AbiesDSP/headphone_dac_proto/README.md

# headphone_dac_proto
Prototype USB DAC to test Cypress PSoC 5lp USB "bridge", I2S DAC, and analog output amplifier
