AbiesDSP/headphone_dac_proto/headphone_dac_proto.kicad_pcb

## KiCad design headphone_dac_proto.kicad_pcb (2020-11-06)

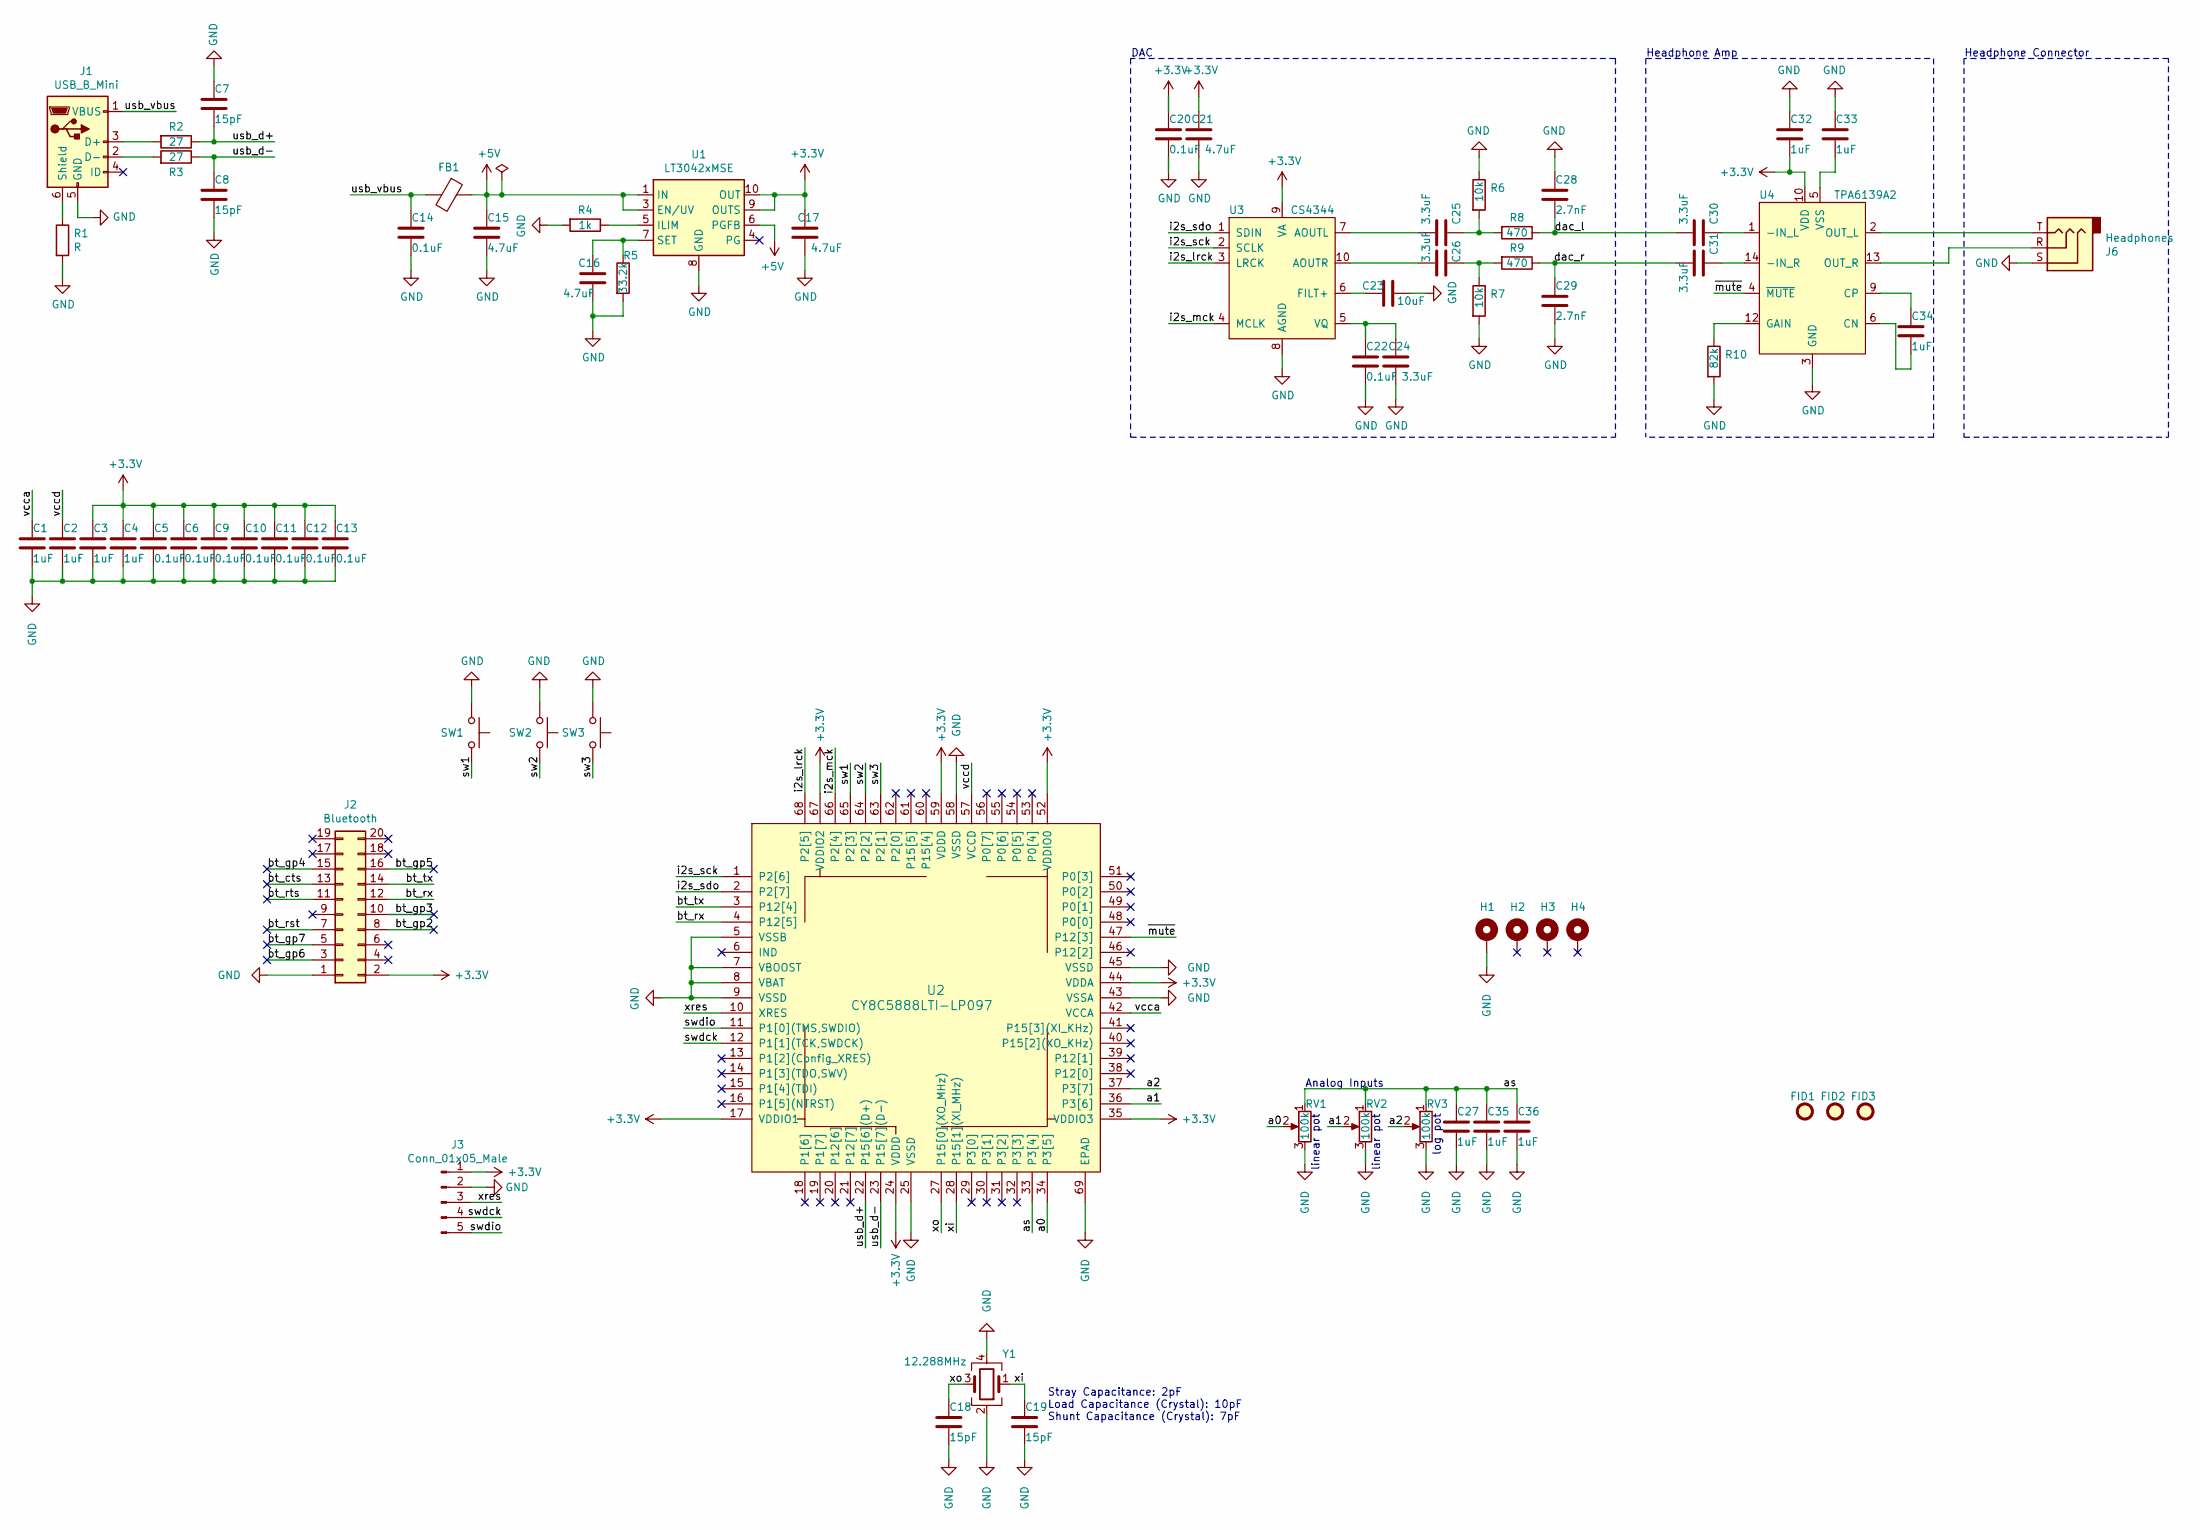
[picture p1: schematic headphone_dac_proto.sch]

Parts:
C1, C2, C3, C4, C27, C32, C33, C34, C35, C36: 1uF; C_0603_1608Metric; Manufacturer Part Number C0603C105K3RAC7411; Mouser Part Number 80-C0603C105K3RLR
C5, C6, C9, C10, C11, C12, C13, C14, C20, C22: 0.1uF; C_0603_1608Metric; Manufacturer Part Number C0603C104K5RAC3121; Mouser Part Number 80-C603C104K5RAC3121
C7, C8, C18, C19: 15pF; C_0603_1608Metric; Manufacturer Part Number C0603C150K5RAC7867; Mouser Part Number 80-C0603C150K5RACTU
C15, C16, C17, C21: 4.7uF; C_0805_2012Metric; Manufacturer Part Number C0805C475K3RACTU; Mouser Part Number 80-C0805C475K3RACTU
C23: 10uF; C_0805_2012Metric; Manufacturer Part Number C0805C106K8RACAUTO; Mouser Part Number 80-C0805C106K8RAUTO
C24, C25, C26, C30, C31: 3.3uF; C_0805_2012Metric; Manufacturer Part Number CGA4J1X7R1E335K125AC; Mouser Part Number 810-CGA4J1X7R1E335K
C28, C29: 2.7nF; C_0603_1608Metric; Manufacturer Part Number C0603C272J5GACAUTO; Mouser Part Number 80-C0603C272J5GAUTO
FB1: L_0603_1608Metric; Manufacturer Part Number KMZ1608SHR601ATD25; Mouser Part Number 810-KMZ1608SHR601ATD
FID1, FID2, FID3: Fiducial_0.5mm_Mask1.5mm
H1: MountingHole_3mm_Pad_Via
H2, H3, H4: MountingHole_3mm_Pad
J1: USB_B_Mini; USB_Mini-B_Wuerth_65100516121_Horizontal; Manufacturer Part Number 65100516121; Mouser Part Number 710-65100516121
J2: Bluetooth; PinHeader_2x10_P2.54mm_Vertical; Manufacturer Part Number M20-9761046; Mouser Part Number 855-M20-9761046
J3: Conn_01x05_Male; PinHeader_1x05_P2.54mm_Vertical; Manufacturer Part Number 22-23-2051; Mouser Part Number 538-22-23-2051
J6: Headphones; Jack_3.5mm_CUI_SJ1-3535NG_Horizontal; Manufacturer Part Number SJ1-3535NG-GR; Mouser Part Number 490-SJ1-3535NG-GR
R1: R; R_0603_1608Metric
R2, R3: 27; R_0603_1608Metric; Manufacturer Part Number CRCW060327R0FKEAC; Mouser Part Number 71-CRCW060327R0FKEAC
R4: 1k; R_0603_1608Metric; Manufacturer Part Number ERJ-UP3D1001V; Mouser Part Number 667-ERJ-UP3D1001V
R5: 33.2k; R_0603_1608Metric; Manufacturer Part Number ERJ-PB3B3322V; Mouser Part Number 667-ERJ-PB3B3322V
R6, R7: 10k; R_0603_1608Metric; Manufacturer Part Number ERJ-UP3F1002V; Mouser Part Number 667-ERJ-UP3F1002V
R8, R9: 470; R_0603_1608Metric; Manufacturer Part Number ERJ-UP3F4700V; Mouser Part Number 667-ERJ-UP3F4700V
R10: 82k; R_Axial_DIN0207_L6.3mm_D2.5mm_P15.24mm_Horizontal; Manufacturer Part Number RCS060382K0FKEA; Mouser Part Number 71-RCS060382K0FKEA
RV1: 100k; Potentiometer_Bourns_PTV09A-1_Single_Vertical; Manufacturer Part Number PTV09A-4025U-A104; Mouser Part Number 652-PTV09A-4025UA104
RV2, RV3: 100k; Potentiometer_Bourns_PTV09A-1_Single_Vertical; Manufacturer Part Number PTV09A-4025F-B104; Mouser Part Number 652-PTV09A4025FB104
SW1, SW2, SW3: SW_PUSH_6mm_H13mm; Manufacturer Part Number SKHHDUA010; Mouser Part Number 688-SKHHDU
U1: LT3042xMSE; MSOP-10-1EP_3x3mm_P0.5mm_EP1.68x1.88mm_ThermalVias; Manufacturer Part Number LT3042EMSE#PBF; Mouser Part Number 584-LT3042EMSE#PBF
U2: CY8C5888LTI-LP097; QFN-68-1EP_8x8mm_P0.4mm_EP5.2x5.2mm_ThermalVias; Manufacturer Part Number CY8C5888LTI-LP097; Mouser Part Number 727-CY8C5888LTILP097
U3: CS4344; TSSOP-10_3x3mm_P0.5mm; Manufacturer Part Number CS4344-CZZR; Mouser Part Number 777-CS4344-CZZR
U4: TPA6139A2; TSSOP-14_4.4x5mm_P0.65mm; Manufacturer Part Number TPA6139A2PWR; Mouser Part Number 595-TPA6139A2PWR
Y1: 12.288MHz; Crystal_SMD_Abracon_ABM3B-4Pin_5.0x3.2mm; Manufacturer Part Number ABM3B-12.288MHZ-10-1-U-T; Mouser Part Number 815-ABM3B-12.288-T

Connections:
+3V3: C3.1, C4.1, C5.1, C6.1, C9.1, C10.1, C11.1, C12.1, C13.1, C17.1, C20.1, C21.1, C32.2, J2.2, J3.1, U1.9 (OUTS), U1.10 (OUT), U2.17 (VDDIO1), U2.24 (VDDD), U2.35 (VDDIO3), U2.44 (VDDA), U2.52 (VDDIO0), U2.59 (VDDD), U2.67 (VDDIO2), U3.9 (VA), U4.10 (VDD)
+5V: C15.1, FB1.1, U1.1 (IN), U1.2 (IN), U1.3 (EN/UV), U1.6 (PGFB)
/a0: RV1.2, U2.34 (P3[5])
/a1: RV2.2, U2.36 (P3[6])
/a2: RV3.2, U2.37 (P3[7])
/as: C27.1, C35.1, C36.1, RV1.1, RV2.1, RV3.1, U2.33 (P3[4])
/bt_cts: J2.13
/bt_gp2: J2.8
/bt_gp3: J2.10
/bt_gp4: J2.15
/bt_gp5: J2.16
/bt_gp6: J2.3
/bt_gp7: J2.5
/bt_rst: J2.7
/bt_rts: J2.11
/bt_rx: J2.12, U2.4 (P12[5])
/bt_tx: J2.14, U2.3 (P12[4])
/dac_l: C28.2, C30.2, R8.1
/dac_r: C29.1, C31.2, R9.1
/i2s_lrck: U2.68 (P2[5]), U3.3 (LRCK)
/i2s_mck: U2.66 (P2[4]), U3.4 (MCLK)
/i2s_sck: U2.1 (P2[6]), U3.2 (SCLK)
/i2s_sdo: U2.2 (P2[7]), U3.1 (SDIN)
/sw1: SW1.1, U2.65 (P2[3])
/sw2: SW2.2, U2.64 (P2[2])
/sw3: SW3.1, U2.63 (P2[1])
/swdck: J3.4, U2.12 (P1[1](TCK,SWDCK))
/swdio: J3.5, U2.11 (P1[0](TMS,SWDIO))
/usb_d+: C7.2, R2.1, U2.22 (P15[6](D+))
/usb_d-: C8.1, R3.1, U2.23 (P15[7](D-))
/usb_vbus: C14.1, FB1.2, J1.1 (VBUS)
/vcca: C1.1, U2.42 (VCCA)
/vccd: C2.1, U2.26 (VCCD), U2.57 (VCCD)
/xi: C19.1, U2.28 (P15[1](XI_MHz)), Y1.1
/xo: C18.1, U2.27 (P15[0](XO_MHz)), Y1.3
/xres: J3.3, U2.10 (XRES)
/~mute~: U2.47 (P12[3]), U4.4 (~MUTE~)
GND: C1.2, C2.2, C3.2, C4.2, C5.2, C6.2, C7.1, C8.2, C9.2, C10.2, C11.2, C12.2, C13.2, C14.2, C15.2, C16.2, C17.2, C18.2, C19.2, C20.2, C21.2, C22.2, C23.1, C24.2, C27.2, C28.1, C29.2, C32.1, C33.1, C35.2, C36.2, H1.1, J1.5 (GND), J2.1, J3.2, J6.S, R1.2, R4.2, R5.2, R6.1, R7.2, R10.2, RV1.3, RV2.3, RV3.3, SW1.2, SW2.1, SW3.2, U1.8 (GND), U1.11 (GND), U2.5 (VSSB), U2.7 (VBOOST), U2.8 (VBAT), U2.9 (VSSD), U2.25 (VSSD), U2.43 (VSSA), U2.45 (VSSD), U2.58 (VSSD), U2.69 (EPAD), U3.8 (AGND), U4.3 (GND), U4.11 (GND), Y1.2, Y1.4
unnamed: C16.1, R5.1, U1.7 (SET)
unnamed: C22.1, C24.1, U3.5 (VQ)
unnamed: C23.2, U3.6 (FILT+)
unnamed: C25.1, R6.2, R8.2
unnamed: C25.2, U3.7 (AOUTL)
unnamed: C26.1, R7.1, R9.2
unnamed: C26.2, U3.10 (AOUTR)
unnamed: C30.1, U4.1 (-IN_L)
unnamed: C31.1, U4.14 (-IN_R)
unnamed: C33.2, U4.5 (VSS)
unnamed: C34.1, U4.9 (CP)
unnamed: C34.2, U4.6 (CN)
unnamed: J1.2 (D-), R3.2
unnamed: J1.3 (D+), R2.2
unnamed: J1.6 (Shield), R1.1
unnamed: J6.R, U4.13 (OUT_R)
unnamed: J6.T, U4.2 (OUT_L)
unnamed: R4.1, U1.5 (ILIM)
unnamed: R10.1, U4.12 (GAIN)

Notes on the sheet:
Stray Capacitance: 2pF Load Capacitance (Crystal): 10pF Shunt Capacitance (Crystal): 7pF
log pot
linear pot
Analog Inputs
DAC
Headphone Amp
Headphone Connector

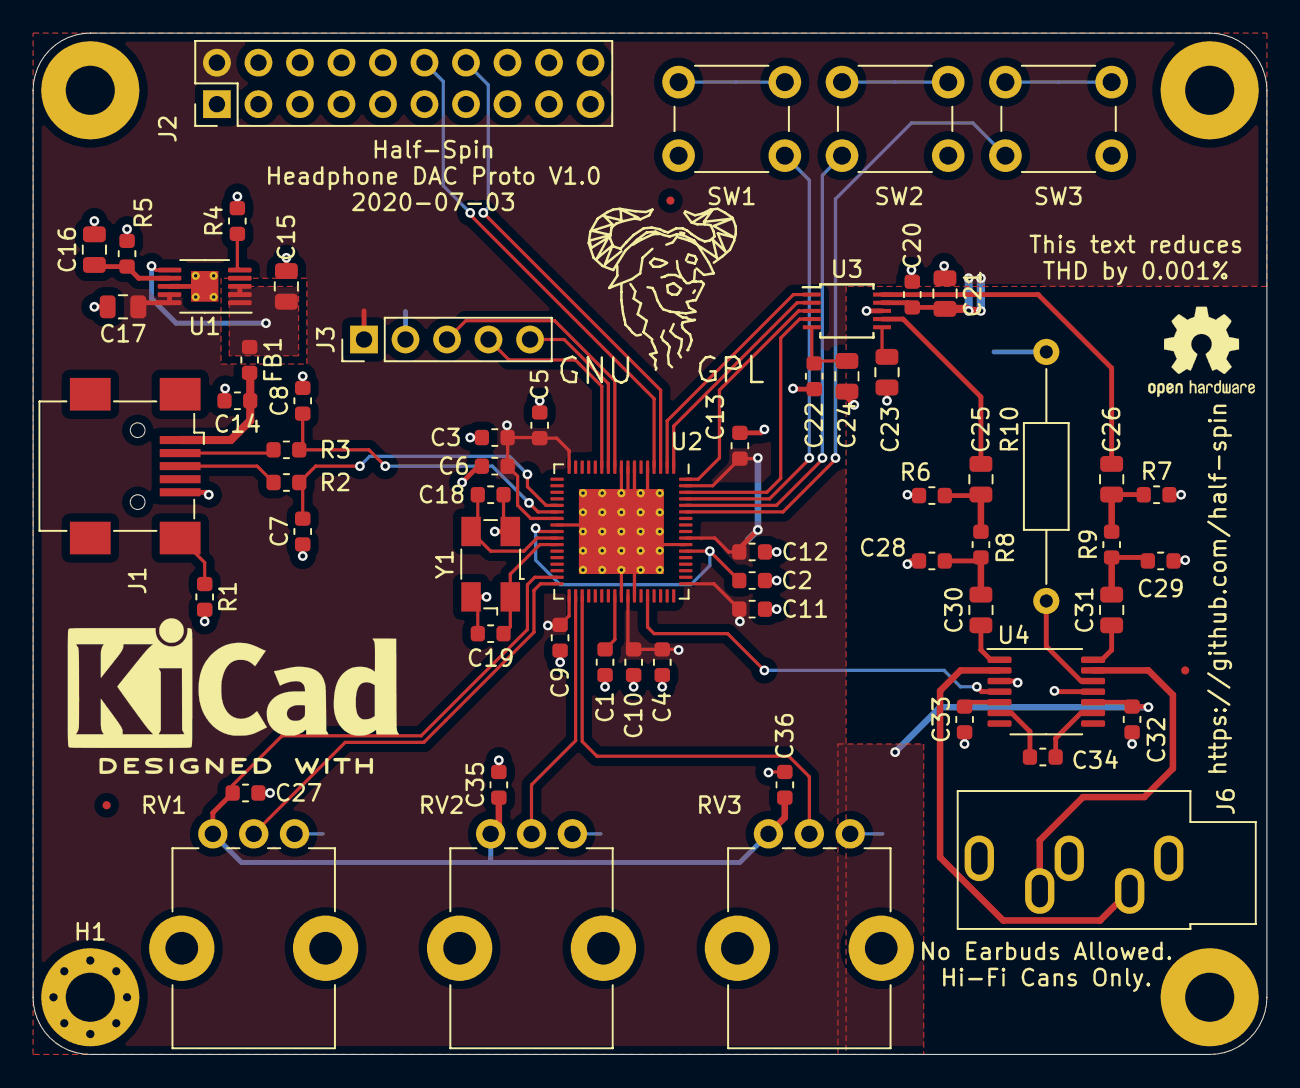
[picture p2: board headphone_dac_proto.kicad_pcb from above]

Board: 2 copper layers, 75.5 x 62.5 mm, 69 parts (0 on the bottom side), 48 nets.
