AbiesDSP/headphone_dac_proto/(threads)

Thread 1 (2020-06-21):

Select microcontroller

jklein3, 2020-06-21:
A microcontroller will be used for USB management and for developing filtering ideas to port in the future to an FPGA.
The microcontroller will primarily need to:
- Take input from USB audio source through USB interface at a sampling rate of 48kHz
- Send the audio signal over I2S to the DAC at the correct sampling rate

jklein3, 2020-06-21:
https://www.cirrus.com/products/cs4344-45-48/

The above microcrontroller will be used for the first phase.

Closed 2020-06-21.

Thread 2 (2020-06-21):

Select DAC chip

jklein3, 2020-06-21:
Select the first DAC chip to be tested in this first phase of the project.

Input: I2C from the microcontroller with sampled audio data
Output: Analogue to Headphone Amp stage

jklein3, 2020-06-21:
https://www.cirrus.com/products/cs4344-45-48/

24 bit DAC, multibit D/A conversion

Closed 2020-06-21.

Thread 6 (2020-06-21):

Select headphone jack

jklein3, 2020-06-21:
3.5 mm headphone jack

Input: Amplified analog signal from the headphone amp.

jklein3, 2020-06-21:
@fsodari did you decide to go with 3.5 mm or 6.35 mm? Looks like 6.35 in the eeschema currently.

Thread 7 (2020-06-21):

PCB Design

jklein3, 2020-06-21:
This issue will house all the code for the PCB design for the first prototype.

Thread 8 (2020-06-21):

Select power regulator

jklein3, 2020-06-21:
Power regulator to supply the board with clean power with as little RF noise as possible.

Input: 5V from USB
Output: 3.3V to all components

jklein3, 2020-06-21:
https://www.analog.com/en/products/lt3042.html#product-overview

Ultralow noise linear regulator

Closed 2020-06-21.

Thread 9 (2020-06-21):

USB Handler

jklein3, 2020-06-21:
The microcontroller will need to be able to handle USB digital audio data, reading the data and transferring it to the DAC.

Decisions to be made:
- Sampling rate - 48 kHz?
- How to synchronize clocks? (Asynchronous, Synchronous, Adaptive)
- Sampling rate to send data to the DAC

More info: http://ww1.microchip.com/downloads/en/AppNotes/00002582A.pdf
Asynchronous:
- Clock on the PC may or may not match the clock on the USB handler
- Can lead to overflow or underflow in the processing depending on how the clock on the PC has drifted
- Handled by a queue and buffering
- Requires feedback back to the PC to tell it to "speed up" or "slow down" as needed

Synchronous:
- Device creates it's USB clock and I2S clocks based on the SOF packet sent from the PC
- Simplifies the buffering that's needed to be done in the signal processing stage

Adaptive:
- Device contains a pool of buffered data packets from the PC
- Device also maintains an average sampling rate by looking at how often samples are actually received from the PC
- If the actual sampling rate gets too high or too low, it adjusts the rate at which samples are sent to the DAC accordingly

jklein3, 2020-06-21:
Will likely want to split this into smaller tickets to handle various sections of the USB handler:
- USB and USB Clock
- Data handler
- I2S and I2S Clock
