AbiesDSP/headphone_dac_proto/(commit log)

2020-06-20 Making progress
    [headphone_dac_proto.kicad_pcb, headphone_dac_proto.sch]
2020-06-30 Initial component placement finished
    [headphone_dac_proto.kicad_pcb, headphone_dac_proto.sch]
2020-06-30 Change to 4 layer board
    [headphone_dac_proto.kicad_pcb]
2020-06-30 Change peripheral switches and pots
    [headphone_dac_proto.kicad_pcb, headphone_dac_proto.sch]
2020-06-30 Change all the things
    [headphone_dac_proto.kicad_pcb, headphone_dac_proto.sch]
2020-06-30 Placement is complete. Actually though.
    [headphone_dac_proto.kicad_pcb, headphone_dac_proto.sch]
2020-07-01 I'm sorry Jackson. Please don't read these commit messages
    [headphone_dac_proto.kicad_pcb, headphone_dac_proto.sch]
2020-07-01 Started routing
    [headphone_dac_proto.kicad_pcb, headphone_dac_proto.sch]
2020-07-02 ERC and DRC passing
    [headphone_dac_proto.kicad_pcb, headphone_dac_proto.sch]
2020-07-02 Switch to two layers. ERC, DRC passing agaom
    [headphone_dac_proto.kicad_pcb]
2020-07-02 More cleanup
    [headphone_dac_proto.kicad_pcb, headphone_dac_proto.sch]
2020-07-03 Change programming connector. Finish BOM
    [headphone_dac_proto.kicad_pcb, headphone_dac_proto.sch]
2020-07-03 Update labels
    [headphone_dac_proto.kicad_pcb]
2020-07-03 Add logos and links. #networking
    [headphone_dac_proto.kicad_pcb, headphone_dac_proto.sch]
2020-07-03 Ignore gerber directory
    [headphone_dac_proto.kicad_pcb]
2020-11-06 Add 3dmodels to board
    [headphone_dac_proto.kicad_pcb, headphone_dac_proto.sch]
2020-11-06 change paths
    [headphone_dac_proto.kicad_pcb]
2020-11-06 Fix bom
    [headphone_dac_proto.sch]
